indrora/veetee2350/docs/devlog/README.md

# VeeTee 2350 devlog

A running log of the build, one entry per micro-milestone, each with a
capture from the HDMI grabber (Genki ShadowCast 2) and notes on what
was learned.

1. [Choosing a parser: the libghostty-vt spike](001-choosing-a-parser.md)
2. [First light: DVI on GPIO 32–39](002-first-light.md)
3. [Fonts, and the case of the out-lined helper](003-fonts-and-text.md)
4. [It's a terminal](004-its-a-terminal.md)
5. [Two cores, one picture](005-two-cores.md)
6. [Switching fonts live](006-font-switching.md)
7. [A keyboard port, and making core 1 flash-free](007-keyboard-port.md)
8. [SET-UP](008-set-up.md)
9. [Six resolutions, two lurking bugs](009-resolutions.md)
10. [Knowing its own size](010-terminal-size.md)
11. [Emulation levels](011-emulation-level.md)
12. [Taking the tests](012-conformance.md)
13. [132 columns](013-132-columns.md)
14. [Sixel](014-sixel.md)
15. [Old-school fonts, and an SD card slot](015-oldschool-fonts.md)
16. [Fonts and colour schemes from the SD card](016-card-fonts-schemes.md)
17. [Screenshots, by the terminal itself](017-screenshots.md)
18. [Turning on the printer](018-printer.md)
19. [Fewer bytes, fewer bits, and Floyd–Steinberg](019-colour-depth.md)
20. [A night with esctest](020-conformance-night.md)
21. [A Tools menu, hotkeys, and a profiler bar](021-tools-menu.md)
22. [User lights and a status line that peeks](022-status-line.md)
23. [Capture and replay](023-capture-replay.md)
24. [A frame planner](024-frame-planner.md)
25. [ATI Small Wonder, a 72 Hz mode, and debug builds that show it](025-small-wonder.md)
26. [fastfetch](026-fastfetch.md)
27. [A USB keyboard on the board itself](027-usb-keyboard.md)
28. [A way out: BOOTSEL factory reset, the USB keyboard in every mode, a SET-UP that asks](028-a-way-out.md)
29. [Hands for the robot: an automation HID for debug builds](029-automation-hid.md)
30. [A real serial line: the header's UART, SET-UP split into pages, a poor man's getty](030-serial-line.md)
31. [Writing only in the blanking gap: no more torn frames under a flood](031-blanking-gap.md)
32. [A boot splash for the capture card](032-boot-splash.md)

How entries are made: capture with
`ffmpeg -f avfoundation -framerate 30 -i "ShadowCast 2" -frames:v 1 x.jpg`
from a terminal that has camera permission, then downscale into `img/`
with `sips -s format jpeg -s formatOptions 50 --resampleWidth 1280`.
