indrora/veetee2350/fonts/arbata-compact/readme.txt

2500+ glyphs pixel game font!

------------------------------------

Arbata Compact

Пиксельный шрифт из 2500+ символов для игр и развлечений. Максимальная высота символа 12px, базовая высота 7px для заглавных букв и 5px для срочных. Средняя ширина 5px для заглавных букв и 4px для срочных. Шрифт выглядит чётко при 12pt в 96dpi.

Почему я нарисовала этот шрифт:
* Мне нужно было, чтобы английские и русские буквы были максимально похожи друг на друга прямо в одном шрифте.
* Я не умею тормозить, и раз уж нарисовала А, то нарисую также À,Á,Â,Ã,Ä и Å, а потом запланирую Ạ,Ả,Ấ,Ầ,Ằ,Ẳ,Ẵ и Ặ на следующий апдейт.
* Я люблю игры, поэтому в шрифте очевидно должна быть полная колода карт и кнопочки геймпада.

Зачем вам нужен этот шрифт:
* В вашей жизни не хватало нового пиксельного шрифта с кириллицей.
* Вы хотите играть в карты и домино в текстовом редакторе.
* Вы нашли применение пиксельному шрифту Брайля.

Что есть в этом шрифте:
+ Латиница и ещё латиница с чёрточками и кружочками.
+ Кириллица и ещё кириллица с полочками и закорючками.
+ Много греческого тоже с закорючками.
+ Числа обычные, надстрочные, подстрочные, дроби.
+ Математические операторы, стрелки, фигуры.
+ Набор линий и блоков для рисования таблиц.
+ Колода карт, коробка домино, шахматы.
+ Ноты, цветочки, флажки и фазы луны.
+ Шрифт Брайля. Затем.

Чего (пока) нет в этом шрифте из важного:
- Никаких азиатских языков.
- Никаких африканских языков.
- Большинства эмодзи.
- Вообще много чего не влезло в 2500 символов, если честно.

Что будет в ближайшем обновлении:
* Больше иконок, которые можно использовать в играх и программах.
* Какая-нибудь дичь, которая мне больше всего понравится при случайном поиске по таблицам юникода. Я уже нашла древне-пермское письмо и приглядываюсь к нему, вместо того чтобы рисовать иероглифы.
* Ещё один шрифт на базе этого. В нём латиница и кириллица будут чуть пошире, а остальные символы такие же.

Что будет в более поздних обновлениях:
* Надеюсь, какие-нибудь иероглифы.
* Вся расширенная латиница и кириллица.
* Что-нибудь по заявкам пользователей.

Чего бы мне хотелось от вас:
* Комментариев, лайков, подписок. Я хочу общаться.
* Чтобы вы использовали этот шрифт в играх и по возможности упоминали меня в виде имени или ссылки сюда. Если упоминание по-русски, то я Ольга Яковлева.
* Чтобы вы задумались о донате мне, если вам шрифт понравился или вы его где-то использовали.
* Чтобы вы не использовали ничего из моих ассетов ни в чём, что связано с NFT.
------------------------------------

Arbata Compact

A pixel font with 2500+ glyphs for games and entertainment.  Max height is 12px, base height is 7px for capital letters and 5px for small letters. Average width is 5px for capital letters and 4px for small letters. The font looks sharp at 12pt in 96dpi.

Reasons for this font's existence:
* I wanted to have a font with very similar looking Latin and Cyrillic.
* I can't stop doing what I'm doing, so as I've finished A, I'm already drawing À,Á,Â,Ã,Ä, and Å, while planning to draw Ả,Ấ,Ầ,Ằ,Ẳ,Ẵ, and Ặ as soon as possible.
* I love games so there has to be a full deck of cards in my font, obviously.

You need this font because:
* Your life felt meaningless without a new pixel font with enough Cyrillic in it.
* You want to play cards and dominoes in your text editor.
* You've found a use for pixel Braille patterns.

What's there in this font:
+ Latin and more Latin with dashes and circles.
+ Cyrillic and more Cyrillic with sticks and hooks.
+ Greek also with sticks.
+ Numbers: regular, subscript, superscript, fractions.
+ Math, arrows, and stuff.
+ A set of lines and blocks to draw a table.
+ A deck of cards, a box of domino, and chess.
+ Notes, flowers, flags and moon phases.
+ Braille patterns. Just because.

What's missing:
- Asian languages.
- African languages.
- Most emojis.
- Frankly speaking, there's a lot that didn't fit into 2500 glyphs.

Plans for the next update:
* More pictograms for games and software.
* Something completely unnecessary but pretty like old permic instead of much needed hanzi and kana.
* Another font based on this one. It will feature more rounded Latin and Cyrillic.

Plans for later updates:
* Hopefully, some Asian languages.
* Full extended Latin and Cyrillic.
* Something from user suggestions.

What can you do for me:
* Comment-like-share-and-subscribe. I want to communicate.
* Use this font in games and credit me by linking here or mentioning my name if possible. If you use Latin-based languages, I'm Olga Yakovleva.
* Consider donating, if you use my font and if you like it.
* Don't use my assets anywhere related to NFTs.

------------------------------------
