indrora/veetee2350/capture.jpg

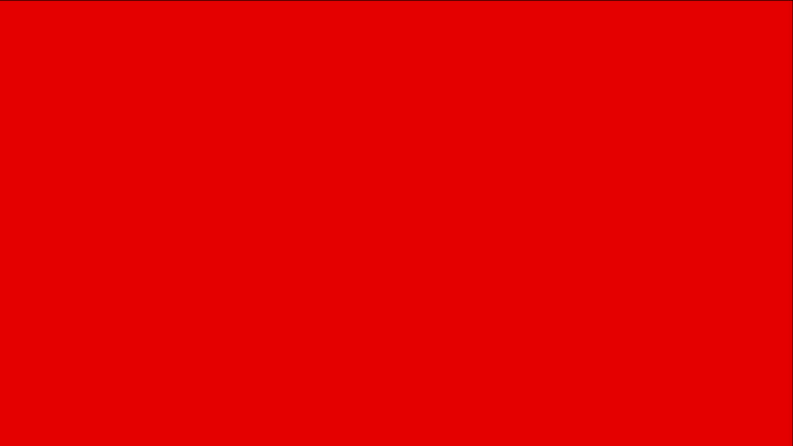
capture.jpg
