indrora/veetee2350/hardware/jlcpcb/production_files/BOM-hardware.csv

Comment | Designator | Footprint | LCSC | Quantity
100nF | C1,C2,C3,C4,C5,C6,C8 | C_0603_1608Metric | C14663 | 7
10k | R1,R2,R4,R5 | R_0603_1608Metric | C25804 | 4
10uF | C7 | C_0603_1608Metric | C19702 | 1
250mA hold | F1 | Fuse_1206_3216Metric | C70069 | 1
2N7002W | Q1,Q2 | SOT-323-3_L2.0-W1.3-P1.30-LS2.1-BR | C7420322 | 2
4.7k | R6,R7 | R_0603_1608Metric | C23162 | 2
DB9 male (DTE) | J2 | DSUB-TH_DMR-9P | C141880 | 1
PS/2 mini-DIN-6 | J3 | CONN-TH_DS1093-01-PN60 | C77848 | 1
TPT3122EH-QF8R | U1 | QFN-24_L4.0-W4.0-P0.50-TL-EP2.7 | C19188736 | 1
