indrora/veetee2350/docs/devlog/img/mode-640x480.jpg

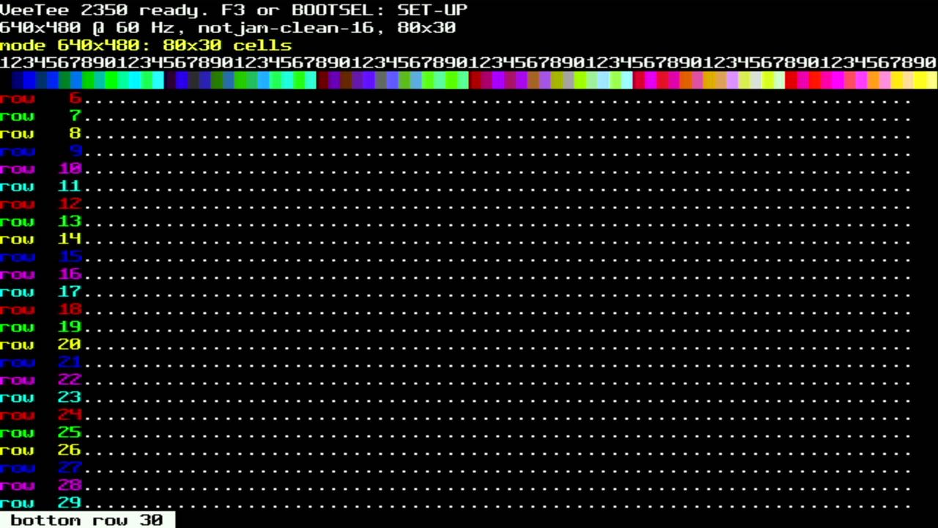
docs/devlog/img/mode-640x480.jpg
