indrora/veetee2350/hardware/hardware.kicad_pcb

## KiCad design hardware/hardware.kicad_pcb (2026-11-04)

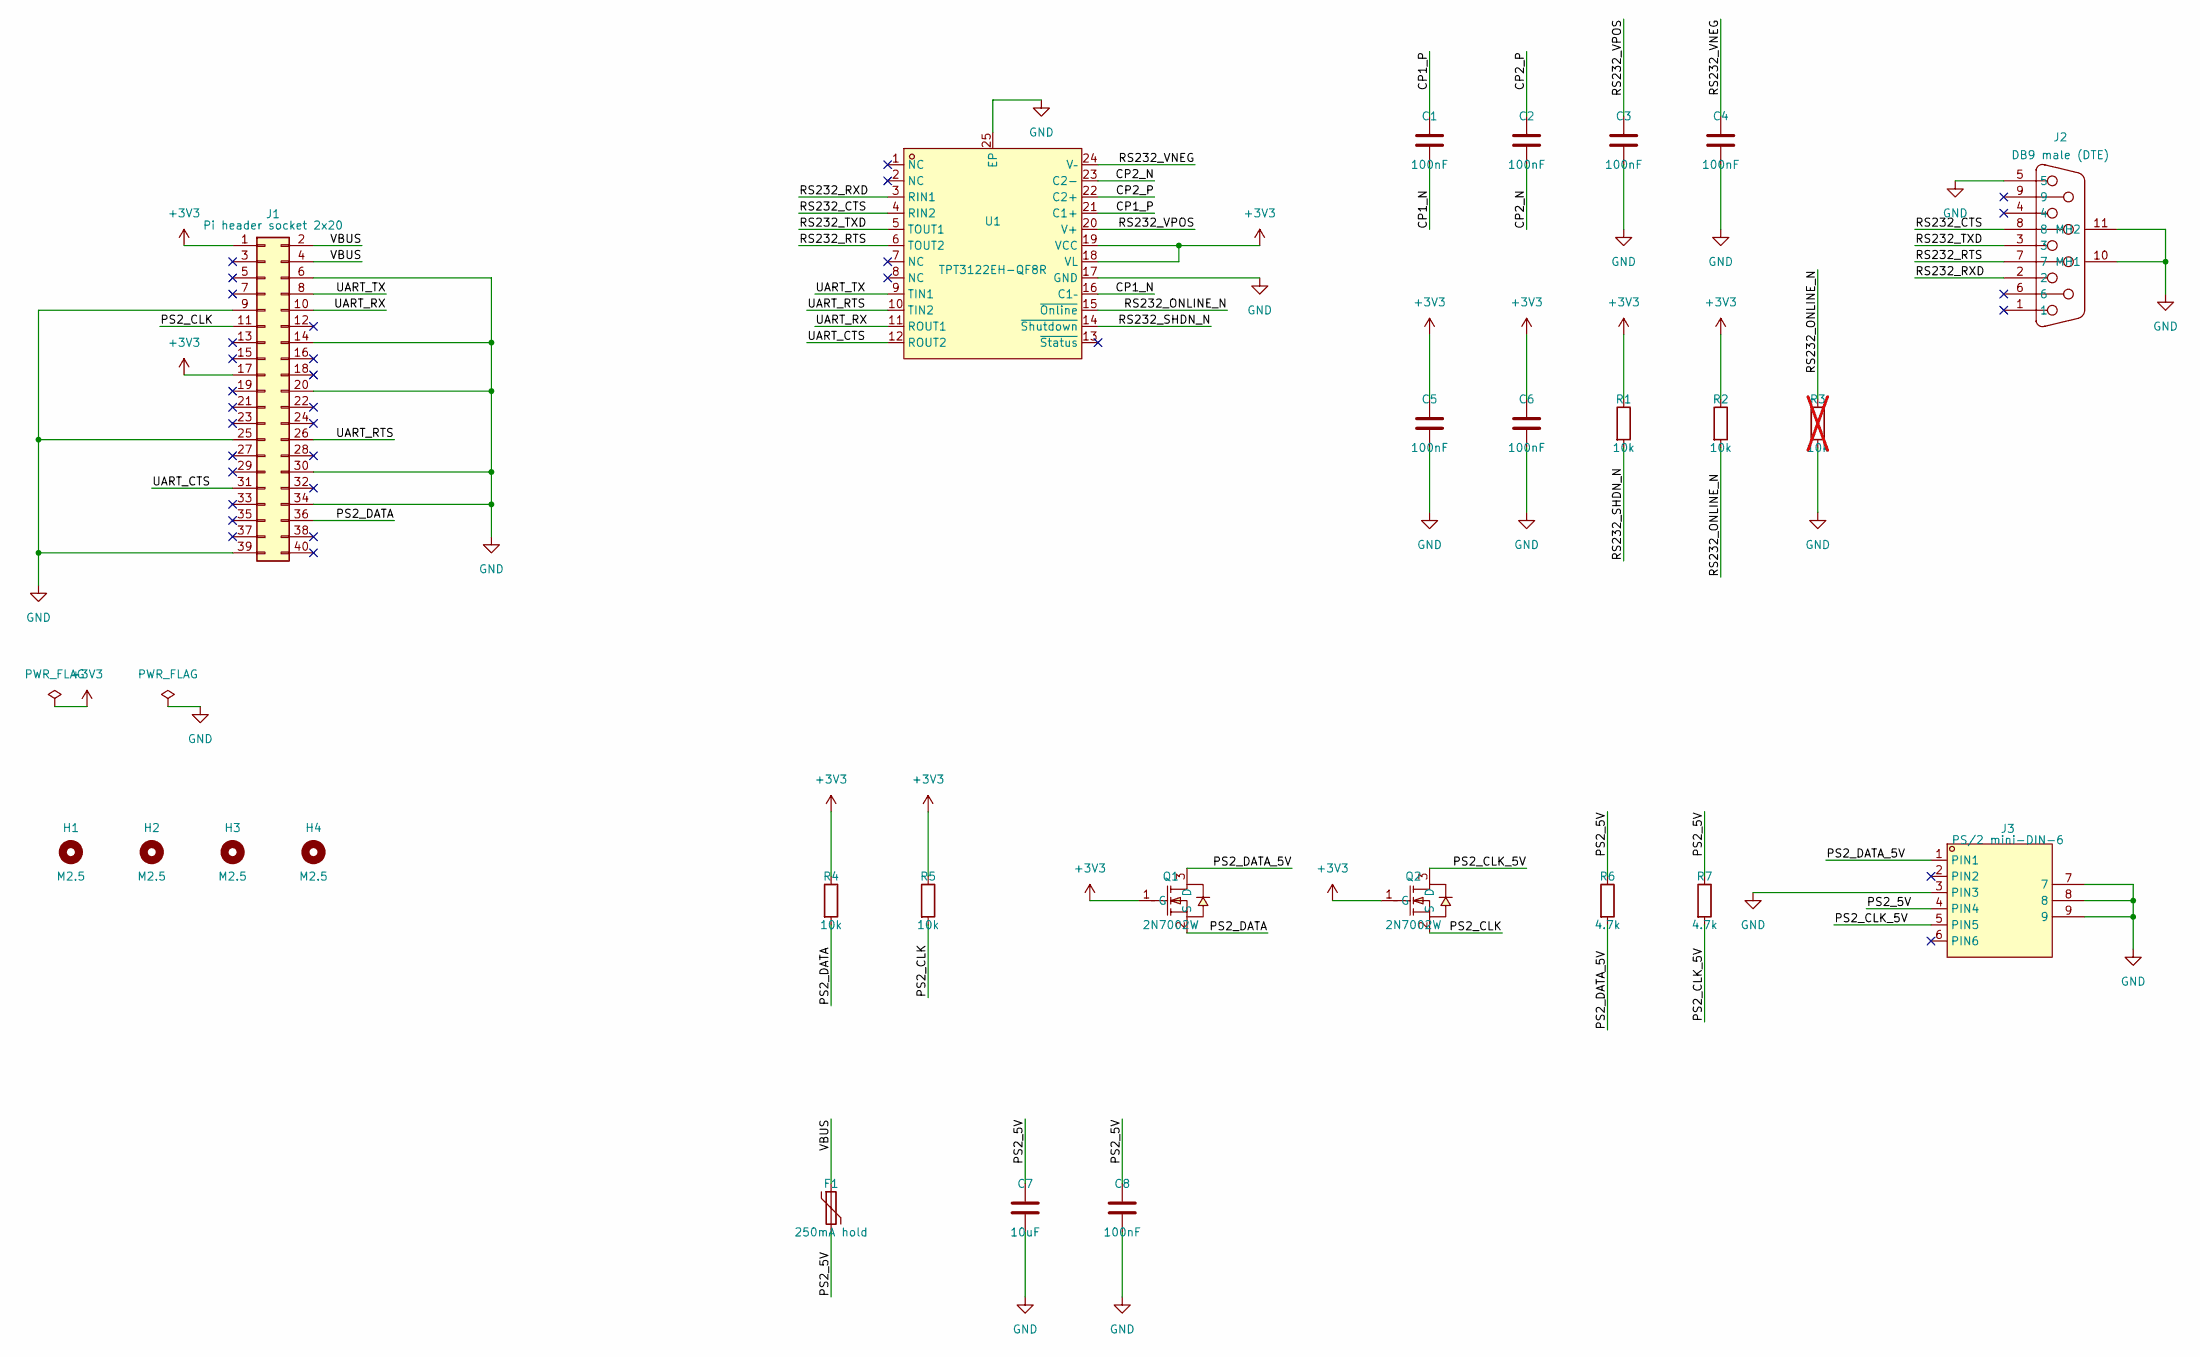
[picture p111: schematic hardware.kicad_sch, VeeTee 2350 HAT: RS-232 + PS/2]

Parts:
C1, C2, C3, C4, C5, C6, C8: 100nF; C_0603_1608Metric; LCSC C14663
C7: 10uF; C_0603_1608Metric; LCSC C19702
F1: 250mA hold; Fuse_1206_3216Metric; LCSC C70069
H1, H2, H3, H4: M2.5; MountingHole_2.7mm_M2.5
J1: Pi header socket 2x20; PinSocket_2x20_P2.54mm_Vertical; LCSC TBD
J2: DB9 male (DTE); DSUB-TH_DMR-9P; LCSC C141880
J3: PS/2 mini-DIN-6; CONN-TH_DS1093-01-PN60; LCSC C77848
Q1, Q2: 2N7002W; SOT-323-3_L2.0-W1.3-P1.30-LS2.1-BR; LCSC C7420322
R1, R2, R4, R5: 10k; R_0603_1608Metric; LCSC C25804
R3: 10k; R_0603_1608Metric; LCSC C25804; not fitted
R6, R7: 4.7k; R_0603_1608Metric; LCSC C23162
U1: TPT3122EH-QF8R; QFN-24_L4.0-W4.0-P0.50-TL-EP2.7; LCSC C19188736

Connections:
+3V3: C5.1, C6.1, J1.1, J1.17, Q1.1 (G), Q2.1 (G), R1.1, R2.1, R4.1, R5.1, U1.18 (VL), U1.19 (VCC)
/CP1_N: C1.2, U1.16 (C1–)
/CP1_P: C1.1, U1.21 (C1+)
/CP2_N: C2.2, U1.23 (C2-)
/CP2_P: C2.1, U1.22 (C2+)
/PS2_5V: C7.1, C8.1, F1.2, J3.4 (PIN4), R6.1, R7.1
/PS2_CLK: J1.11, Q2.2 (S), R5.2
/PS2_CLK_5V: J3.5 (PIN5), Q2.3 (D), R7.2
/PS2_DATA: J1.36, Q1.2 (S), R4.2
/PS2_DATA_5V: J3.1 (PIN1), Q1.3 (D), R6.2
/RS232_CTS: J2.8, U1.4 (RIN2)
/RS232_ONLINE_N: R2.2, R3.1, U1.15 (~Online)
/RS232_RTS: J2.7, U1.6 (TOUT2)
/RS232_RXD: J2.2, U1.3 (RIN1)
/RS232_SHDN_N: R1.2, U1.14 (~Shutdown)
/RS232_TXD: J2.3, U1.5 (TOUT1)
/RS232_VNEG: C4.1, U1.24 (V–)
/RS232_VPOS: C3.1, U1.20 (V+)
/UART_CTS: J1.31, U1.12 (ROUT2)
/UART_RTS: J1.26, U1.10 (TIN2)
/UART_RX: J1.10, U1.11 (ROUT1)
/UART_TX: J1.8, U1.9 (TIN1)
/VBUS: F1.1, J1.2, J1.4
GND: C3.2, C4.2, C5.2, C6.2, C7.2, C8.2, J1.6, J1.9, J1.14, J1.20, J1.25, J1.30, J1.34, J1.39, J2.5, J2.10 (MH1), J2.11 (MH2), J3.3 (PIN3), J3.7, J3.8, J3.9, R3.2, U1.17 (GND), U1.25 (EP)

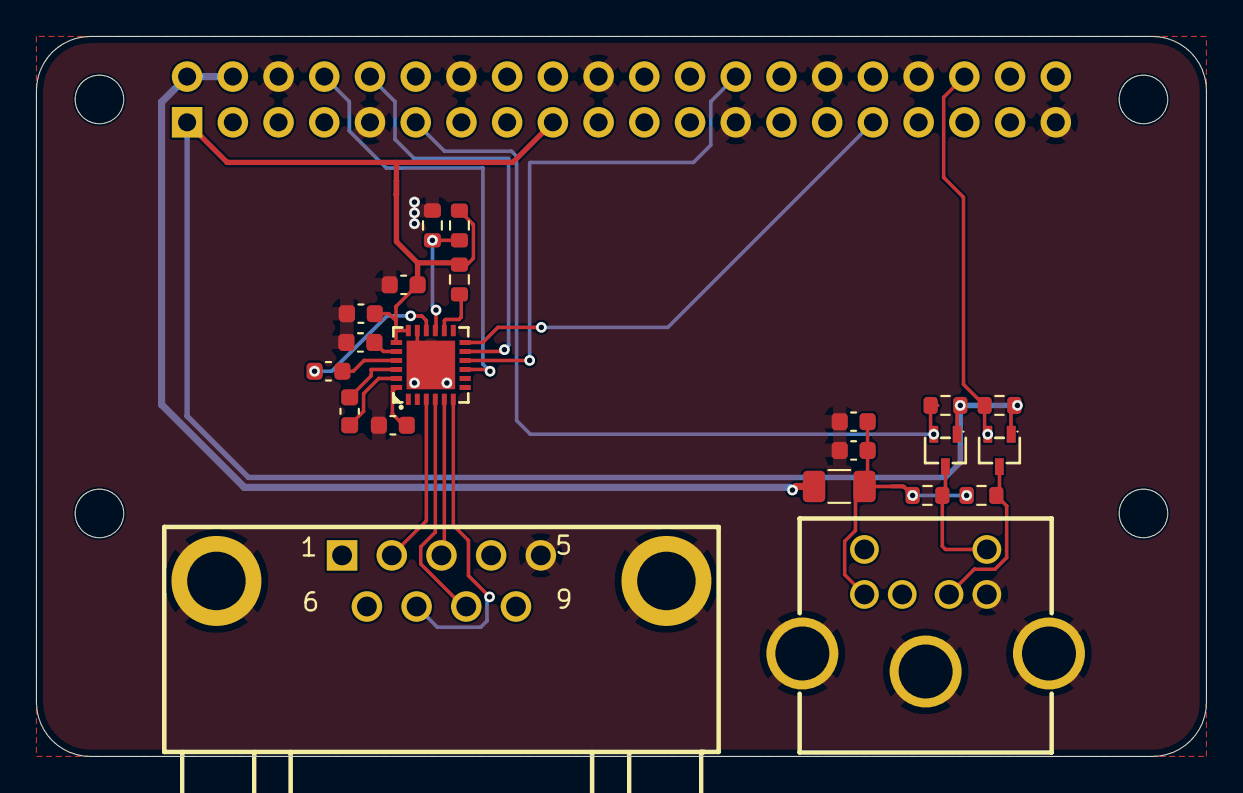
[picture p112: board hardware.kicad_pcb from above]

Board: 2 copper layers, 65.0 x 40.0 mm, 26 parts (1 on the bottom side), 24 nets.
