indrora/veetee2350/(commit log)

2026-11-02 build: scaffold PlatformIO project with DVI test pattern
    Adds STYLE.md and CLAUDE.md, a PlatformIO env for the Waveshare
    RP2350-PiZero (arduino-pico, C23), vendored libdvi patched for TMDS
    pins on GPIO 32-39, a video HAL that renders RGB565 scanlines on core 1
    through the SIO TMDS encoder, and a test pattern that reports per-line
    cycle usage over USB serial.
2026-11-02 hal: fit DVI scanout in the line budget, document hardware
    Two TMDS symbols per FIFO word lets the SIO encoder pop a pixel pair per
    read; with a 4x unrolled loop and core 1 bus priority, encode drops from
    9.2k to 4.4k cycles per line (budget 8k), giving a stable 60 fps. The
    test pattern now copies precomputed rows. Verified on hardware via the
    Genki capture: bar order, ramps and pixel checkerboard are correct.
2026-11-02 render: text demo on hardware, fit the renderer near the line budget
    Demo screen cycles through all built-in fonts (verified by capture:
    colours, truecolor sweep, attributes, box/DEC glyphs, cursor). Render cost
    cut from ~6300 to ~3000 cycles/line: force-inline hot helpers (-Os had
    out-lined one into flash), build lib/render at -O2, index a 256-entry
    mask table by the whole glyph byte, and apply attributes through a
    precomputed per-row (and, or) table instead of a call. Measurements and
    the capture-by-name command are in docs/hardware.md.
2026-11-02 term: libvterm-driven terminal on the DVI screen
    Vendors libvterm 0.3.3 (MIT, unmodified) and adds lib/term, which turns
    its state-layer callbacks into grid writes: glyphs with resolved SGR
    colours/attributes, row-map fast scrolling with moverect/erase fallback,
    BCE erase, alternate screen as a second grid, cursor/DECSCNM/DECSCUSR
    modes, and device replies back to the host. USB CDC bytes now feed the
    terminal. tools/hostshell.py runs a Mac shell in an 80x30 pty bridged to
    the board; verified on hardware with a colour/DEC graphics demo and less
    (captures/g1-*.jpg). 23 host tests pass. Notes in docs/terminal.md.
2026-11-02 hal: render on core 0 from a doorbell IRQ, encode-only core 1
    The scanline callback now runs on core 0 in a top-priority SIO doorbell
    IRQ, filling an 8-line ring that core 1 drains for TMDS encoding. On the
    worst-case screen core 1 is a steady 4348/8000 cycles and core 0 renders
    in ~3660, with no starved lines (it used to be ~8074/8000 with both on
    core 1). Doorbell 7, not 0: arduino-pico's shared bell handler idles the
    core forever on doorbell 0 even in single-core mode.
    Adds a pizero-stats env for measuring, and tools/refscreen.py (pyte) as
    an independent reference screen. fastfetch verified on hardware
    (captures/g1-fastfetch.jpg) and matches pyte row for row.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
2026-11-02 term: runtime font switching via OSC 50
    The terminal now owns its font. xterm's OSC 50 selects a built-in font by
    name (or #+/#- to cycle, ? to query); a switch rebuilds both screens at
    the new grid size, resizes libvterm and hard-resets it. libvterm rects
    are clamped to the grid for the resize window, and render_pause only
    waits when scanout is live. tools/setfont switches and re-reads the size
    resize(1)-style so the pty gets SIGWINCH; tools/fontshow.sh cycles fonts.
    Verified on hardware in five fonts (captures/font-*.jpg). 25 host tests.
2026-11-02 hal: second USB CDC as the keyboard port; core 1 made flash-free
    Switches to Adafruit TinyUSB (the native stack has one CDC) and adds a
    "VeeTee keyboard" CDC next to the "VeeTee line": keys written to it are
    forwarded to the host over the line, completing Goal 1's loopback
    keyboard. hal/usbio.h replaces console.h; hostshell.py --keyboard routes
    the Mac's keys through the device.
    Core 1 was executing flash after all: -Os out-lined libdvi's queue
    helpers, the SDK queue level helper and dma_channel_get_default_config
    (called per scanline in the DMA IRQ). They're now force-inlined or
    precomputed (PicoDVI PATCHES.md 3-4), PicoDVI and hal build at -O2, and
    tools/core1_audit.py walks core 1's call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
2026-11-02 docs: start the devlog with entries 001-007
    Backfills blog-style entries with downscaled captures for each milestone
    so far (spike, first light, fonts, terminal, two cores, font switching,
    keyboard port) and notes the practice in CLAUDE.md.
2026-11-02 feature: VT-style SET-UP screen with settings saved to flash
    F3 on the keyboard port (or the BOOTSEL button) opens SET-UP: font
    (terminal size), rows (auto/24/25), colour scheme (xterm grey, green/
    amber/white phosphor, paper), cursor shape/blink, auto-wrap, new-line
    mode, local echo, visual bell and answerback, plus save/recall/defaults/
    reset. It draws into its own grid so the session underneath is left
    alone. Settings are a CRC-sealed record in the last flash sector, applied
    at boot and on exit; modes are applied by feeding libvterm the escape
    sequences a host would send; ENQ answers with the answerback.
    New pure modules lib/input (key decoder) and lib/setup (settings, menu)
    with host te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
2026-11-02 feature: six output resolutions up to 1280x720, crash recovery
    SET-UP gains Resolution: 640x480, 720x480, 800x480, 960x540 @60,
    1280x720 @30 and a 1280x720 @24 "low clock" mode (297 MHz). Each mode
    sets VREG, flash timing and sysclk = TMDS bit clock at boot; video and
    render now use runtime sizes; changing mode saves and reboots. All six
    verified on the Genki.
    Fixes found on the way:
    - libdvi TMDS buffers overran by up to 15 words when a lane isn't a
    multiple of the unrolled encode block (720 px), corrupting the next
    heap block (PicoDVI PATCHES.md 5).
    - Flash QMI timing: computed per clock (probed with the new
    pizero-flashprobe env), a transition timing while set_sys_clock_khz
    runs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
2026-11-02 feature: terminal size setting and host size sync (DECSET 2048)
    Full-screen apps used only part of the screen because the host never
    learned the grid size. The terminal now answers xterm window-op size
    queries (CSI 14/16/18/19 t) and implements in-band resize reports
    (DECSET 2048: CSI 48;rows;cols;h;w t on enable and after every font/
    size/resolution change, plus DECRQM). libvterm patch: unknown DEC modes
    and their DECRQM go to the CSI fallback. hostshell.py enables 2048,
    starts the shell at the reported size and applies later reports with
    TIOCSWINSZ (SIGWINCH).
    SET-UP "Rows" becomes "Terminal size": full or fixed 80x24/25/43/50 and
    132x24/43, letterboxed and clamped to what fits (settings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
2026-11-02 feature: emulation level (VT100/VT220/VT340/xterm) with feature toggles
    SET-UP gains Emulation, Colour depth, UTF-8 and Alternate screen. A level
    sets the DA1/DA2 replies (libvterm patch 2 lets the embedder answer DA)
    and loads feature defaults that can then be overridden:
    - colour depth: mono ignores SGR colours, 16/256 map to the nearest
    ANSI / xterm-256 colour (new lib/term/colour), 24-bit passes through;
    - UTF-8 off: C1 bytes become 7-bit ESC forms and GR bytes Latin-1, done
    in front of libvterm (which only has 94-character sets);
    - alternate screen off: the settermprop callback vetoes the switch so
    libvterm doesn't erase the primary screen.
    Settings v4; SET-UP relaid out to fit 80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
2026-11-02 term: DECRQCRA readback, protected cells, double-width/height lines
    - DECRQCRA (CSI Pid;Pp;Pt;Pl;Pb;Pr * y -> DCS Pid !~ XXXX ST): codepoint
    sum over a rectangle, erased cells 0, via a glyph->codepoint table in
    the font and a CELL_ERASED marker (masked out by the renderer). This
    lets esctest2 read the screen back. libvterm patch 3: CSI with
    intermediates it doesn't parse reaches the fallback.
    - DECSCA protection: CELL_PROTECTED from libvterm's protected_cell;
    selective erase (DECSED/DECSEL) skips protected cells.
    - DECDWL/DECDHL: per-physical-row line size from setlineinfo (moves with
    scrolling, reset on new lines), rendered by a pixel-doubling slow path
    with double-height halv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
2026-11-02 term: conformance work driven by esctest2 (30% -> 68% so far)
    - DECRQCRA counts erased cells as spaces (xterm >= 334, as claimed).
    - OSC 4/5/104/105, OSC 10-19/110-119 colour set/query/reset (X11 rgb:,
    rgbi:, #hex specs), OSC 4 256+ special-colour aliases.
    - XTGETTCAP (Co/colors, TN/name, RGB).
    - DECRQM for ANSI and DEC modes: real IRM/LNM, permanently-reset ANSI
    modes, and a store for accepted-but-inert modes (DECARM, DECNKM, ...).
    - DECDSR printer/UDK/keyboard/locator/macro/checksum/integrity/session.
    - REP; DECFRA/DECERA/DECSERA/DECCRA rectangles; DECRQCRA in origin mode.
    - libvterm patches 4-7: unknown ANSI modes and DSR to the fallback,
    DECXCPR page, SCOSC/SCORC, reverse wraparoun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
2026-11-02 test: esctest2 at 72%, DECRQSS, vttest capture tour, devlog 012
    esctest2 now passes 408 of 567 (baseline 169). This round:
    - libvterm patch 8: DECRQSS SGR replies in xterm's replayable "0;..."
    form, and settings libvterm doesn't track go to the DCS fallback,
    where lib/term answers DECSCL, DECSLPP, DECSNLS, DECSACE, DECSASD
    and DECSSDT.
    - libvterm patch 7 extended: RIS/DECSTR clear reverse wrap and the
    DECSC save (position, DECOM, protection), and seed the saved pen
    with the default pen, so DECRC with nothing saved no longer restores
    black-on-black RGB.
    - tools/vttest_tour.sh drives vttest through the keyboard port and
    grabs a frame per screen; devlog 012 has the results, inclu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
2026-11-02 feature: DECCOLM 132-column mode where the screen fits; libvterm resize fix
    CSI ?3h switches to 132 columns when the resolution and font have room
    (the 720p modes, 1056 px at 8 px per column) and is ignored otherwise,
    like xterm with 80/132 switching disallowed. CSI ?3l returns to the
    width SET-UP configured, so `reset` can't shrink a full-width screen.
    A switch clears (unless DECNCSM), homes, resets margins and sends a
    DECSET 2048 size report. Mode 40 can disable it. It runs synchronously
    in libvterm's CSI dispatch so the rest of the chunk lands at the new
    width.
    libvterm patch 9: on_resize() never reallocated the per-row line info
    (it compared against state->rows after overwriting it, and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
2026-11-02 feature: Sixel graphics as graphic cells
    Images from "DCS P1;P2;P3 q ... ST" are drawn into CELL_GRAPHIC cells:
    the glyph index names a font-cell-sized 8-bit tile in a heap pool, and
    the renderer copies tile rows through a shared 256-entry RGB565 palette
    (255 = transparent). Scrolling, erase, DECCRA, the alternate screen and
    text overwrite all work through the existing grid. Unreferenced tiles
    are reclaimed by a mark-sweep over both screens.
    - lib/sixel: streaming decoder (raster attributes, RGB/HLS colour
    definitions, repeats, bands), no allocation.
    - lib/term/graphics.c: tile pool, palette slots shared by value, xterm
    placement and sixel scrolling, DECSDM (80), private registers
    (10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
2026-11-02 feature: TUOPFP built-in fonts; SD card storage layer
    Fonts from VileR's Ultimate Oldschool PC Font Pack (CC BY-SA 4.0),
    converted to PSF2: rainbow100-80 (the DEC Rainbow's 10x10 double-scan
    font, cropped to an 8x20 cell: 80x24 at 640x480), nix8810-m16,
    fmtowns-8x16 and fmtowns-8x8.
    lib/hal/storage.h: a C file API for the microSD slot, implemented in
    src/storage_sd.cpp on arduino-pico's SdFat over hardware SPI1 (GP30
    SCK, GP31 MOSI, GP40 MISO, GP43 CS; no PIO). SET-UP probes the card on
    entry and shows its size and type, or why it couldn't mount, in the
    title row. Verified on hardware with no card inserted.
    Devlog 015 with the fonts on screen. STYLE.md now names both C++
    shims in src/.
    Co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
2026-11-02 feature: fonts and base16 colour schemes from the SD card
    - src/card.c: /fonts/*.psf and /schemes/*.yaml listed for SET-UP (first
    64 of each, caveat emptor), loaded on apply. The listing is cached in
    /veetee/catalog.bin under an FNV-1a fingerprint of both folders;
    scanning feeds the watchdog and reports progress on SET-UP's message
    line.
    - src/storage_sd.cpp now uses SdFat directly: arduino-pico's SD
    wrapper re-opens each directory entry by path, making listings
    quadratic (a full TUOPFP card tripped the 8 s watchdog). storage_list
    can peek at each file's first bytes through the open entry.
    - lib/setup/base16.c: parser for both base16 file generations and
    base16-shell's termin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
2026-11-02 docs: Configuration Error capture with the card pulled; grabber caveat
    The missing-card case works: both card items listed with their reason,
    defaults used. The grabber wedges on such boots (board stats show
    clean video) until replugged; noted in docs/hardware.md.
2026-11-02 feature: F12 screenshots to the SD card, BMP or QOI
    F12 re-renders every scanline through the live renderer (there is no
    framebuffer) and streams it to /screens/NNNN.bmp (16-bit RGB565,
    top-down) or NNNN.qoi (24-bit, bit-replicated widening). SET-UP gets a
    "Screenshot (F12)" format item (settings v7). Success flashes the
    screen or, in SET-UP, names the file and time; failure says why.
    lib/qoi: a streaming QOI encoder from the spec (the reference encoder
    needs the whole image in RAM). Its colour cache tracks alpha: the
    decoder starts slots at (0,0,0,0), and treating an empty slot as
    opaque black desynchronised the decoder on the first device file.
    Unit tests pin the hand-worked bytes and tha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
2026-11-02 feature: printer port (Media Copy) to /print on the SD card
    SET-UP "Printer" (settings v8). With it on, MC prints to
    /print/NNNN.txt (a new file each time the printer is switched on):
    print screen (scrolling region, or all with DECPEX; DECPFF form feed),
    print cursor line, auto print (CSI ? 5/4 i), and printer controller
    mode (CSI 5 i ... 4 i, raw, not displayed). CSI ? 15 n reports ready /
    not ready / none. Text is UTF-8, trailing blanks dropped, CR LF.
    lib/term/printer.c recognises the controller-mode switches before
    libvterm (which would otherwise consume the rest of the buffer),
    across chunk boundaries, holding at most three bytes; it also splits
    at LF/VT/FF for auto print, flushing ear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
2026-11-02 term: esctest 407 -> 451 -- DECBI/DECFI, margins, window ops, DECID
    - libvterm patch 10: DECBI/DECFI (ESC 6 / ESC 9), scrolling the
    margins sideways at the left/right margin.
    - libvterm patch 11: CR/CNL/CPL go to the left margin; CUU/CUD/CUF/
    CUB/CNL/CPL stop at margins they start inside; CPR/DECXCPR are
    origin-relative.
    - libvterm patch 12: DECALN resets the margins and homes the cursor.
    - Window ops: titles and icon labels from OSC 0/1/2 with reports (20t,
    21t) and xterm's title stack (22t/23t: one stack, every push saves
    both, a pop consumes the entry); iconify/move remembered for 11t/13t;
    15t; resize requests accepted and ignored.
    - DECID (ESC Z, arrives as C1 SCI) answered a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
2026-11-02 term: esctest 451 -> 474 -- per-screen saves, margins for text and index, xterm 383+ reverse wrap, DECSCL levels
    - libvterm patch 13: a DECSC save per screen (main / alternate), as
    xterm; 1049 saves on main before switching.
    - patch 14: LF/IND/NEL/VT/FF/RI outside the left/right margins neither
    scroll nor move past the margin.
    - patch 15: text between DECSLRM margins wraps at the right margin to
    the next line's left margin; no-autowrap sticks there; IRM truncates
    there.
    - patch 16: reverse wraparound as xterm 383+: mode 45 only onto lines
    that wrapped, new mode 1045 always (top margin -> bottom); stops at
    and lands on margins; BS in the pending-wrap position cancels it.
    - patch 1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
2026-11-02 term: esctest 474 -> 489 -- REP, NEL/DCH, CUB reverse wrap, XTSAVE, margin tabs, alt-screen clearing
    libvterm patches 19-26 (see lib/libvterm/PATCHES.md):
    19 REP prints like text (wraps at the right margin), replacing term.c's
    REP fallback.
    20 NEL obeys the CR margin rule; DCH only needs the L/R margins;
    DECSTBM needs at least two lines.
    21 CUB with reverse wraparound is repeated BS (back_space()).
    22 XTSAVE / XTRESTORE (CSI ? Pm s / r), libvterm's own modes in the
    state and term.c's stored modes through the CSI fallback.
    23 HT/CHT stop at the right margin when inside the margins; CBT still
    runs to column 1.
    24 DECSET 41, xterm's more(1) fix.
    25 Alternate-screen clearing per mod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
2026-11-02 term: DECNCSM only at conformance level 5, as xterm
    DECNCSM (mode 95, keep the screen across a DECCOLM switch) is a VT510
    feature. xterm honours it only at level 5; below that the switch clears
    regardless. VeeTee's emulations top out at level 4 (VT420), so the mode
    is now stored and reported but has no effect. Fixes esctest's
    DECSCL_Level4_SupportsDECSLRMDoesntSupportDECNCSM (490 / 567 expected
    on a full run; checked with a DECSCL/DECCOLM/RIS subset).
2026-11-02 term: ISO protected areas (SPA/EPA), libvterm patch 27
    SPA (ESC V) and EPA (ESC W) set and clear the protected bit DECSCA
    already uses, and the state remembers which of the two set it last
    (protect_iso). After SPA, plain ED, EL and ECH spare protected cells
    as xterm does; after DECSCA only DECSED/DECSEL do. DECSERA in term.c
    honours DEC protection only. Soft and hard reset go back to DEC rules,
    so RIS still erases everything (the reason this was left alone before).
    esctest2 run25: ECH/ED/EL_respectsISOProtection pass; DECSED/DECSEL
    _doesNotRespectISOProtect become expected failures (xterm's known bug,
    which we now share); DECSERA_doesNotRespectISOProtect regressed in
    run25 and is fixed here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
2026-11-02 feature: Tools menu on Ctrl+F3, renderer overlays, key modifiers
    - keys.c decodes xterm's modifier parameter (CSI 1;m X, CSI n;m ~,
    SS3 m X) into key_event.mods, and ESC + printable as Alt+key;
    keys_name() formats "Ctrl+F3" for menus.
    - Settings v10: hotkeys per tool (Tools menu Ctrl+F3, Screenshot F12,
    the rest unbound), plus status line, peek time and capture fields for
    the rest of phase H, so the record only changes once.
    - lib/setup/menu.c: the Tools menu (Set-Up, Screenshot, Print screen,
    Printer, Clear screen, Soft reset, Hard reset), drawn into its own
    cells in the theme's colours swapped.
    - render.c: overlays (menu, user lights) composed over a copy of the
    covered rows,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
2026-11-02 feature: SET-UP Hotkeys page, scrolling item list
    SET-UP's new "Hotkeys..." item opens a page listing the tools: Enter,
    then the key to bind (with modifiers; Esc cancels), Delete to unbind.
    A key runs one tool: binding it elsewhere takes it from its old tool,
    and the message line says so. Tools not built yet aren't listed
    (tool_ready() in menu.c).
    The item list now scrolls, with '^'/'v' marks, and the help and message
    lines always sit at the bottom. The old layout put every item on screen
    at once and assumed 24 rows: at 23 items the help line had already
    fallen off an 80x24 screen, and phase H adds more items.
2026-11-02 feature: profiler bar, settings upgrade from older versions
    - SET-UP "Profiler bar": the top 8 scanlines show last frame's cycles
    a line against the budget -- core 0 render (overlay composing in
    yellow, the rest green) and core 1 TMDS encode (blue), red ticks at
    the worst line, white at the budget (80% of the width). Filled once
    a frame by the main loop from hal/video's stats; the compose share
    needs a VEETEE_RENDER_PROFILE build. The profile counters are now
    running totals that readers difference.
    - Settings v11 (profiler_bar). settings_upgrade() reads records from
    version 9 on, whose layouts are prefixes of today's: old fields kept
    (up to where each version's fields ended,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
2026-11-02 feature: VT100 user lights and a status line (bottom, top, peek)
    DECLL (CSI Ps q) sets the four user lights; RIS puts them out (libvterm
    patch 28: a reset notification). lib/term/status.c draws an indicator
    status line -- lights, the printer, Insert, messages, the cursor -- in
    the theme's colours swapped, into a row of cells the renderer draws
    outside the grid (render->status_cells, RENDER_LINE_STATUS lines).
    SET-UP: Status line (hidden / bottom / top / peek bottom / peek top)
    and Peek time (3/5/7/10 s). Bottom and Top reserve a row; the Peek
    modes slide the row in over the edge row on news and away again by
    rewriting that row's line tables (render_status_peek). With no
    indicator on screen,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
2026-11-02 docs: devlog 022, user lights and the peeking status line
    Captures of every mode on the board, two frames caught mid-slide, the
    231-cycle regression and how it went, and the plan's Hidden rule
    revised (a host request no longer resizes the terminal).
2026-11-02 feature: capture to SD as ttyrec, replay with a file picker
    Capture (Tools menu, hotkey, SET-UP) writes host output and local echo
    to /capture/NNNN.rec as ttyrec records, buffered 4 KB, flushed when
    quiet, closed after an idle second. Replay file... opens a picker over
    the screen (lib/setup/picker.c; box drawing shared with the Tools menu
    in box.c) and plays ttyrec with its timing (gaps cut to 2 s) or any
    other file raw at 9600 baud; Space pauses, Up/Down speed (1/4x..max),
    n toggles LF -> CR LF, Esc stops. Host input waits, the terminal's
    replies to replayed queries are dropped. The pacing is pure and
    host-tested (lib/ttyrec).
    SET-UP: Capture, and Replay newlines (as in the file / raw file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
2026-11-02 feature: frame planner -- spans, row kinds, a preloaded colour-pair table
    Once a frame the main loop plans the next (render_plan): each text row
    becomes spans of grid or overlay cells, each PAIR (plain text in the
    frame's commonest fg/bg), PLAIN or MIXED, and the scanline runs a loop
    made for each. Overlays are spans, so nothing is composed in the IRQ.
    PAIR spans draw from a 4 KB table of each glyph byte's pixels already
    in that pair, and their rows are preloaded into SCRATCH_X. A stale plan
    (it may be a frame old) costs speed, never pixels: the lean loops hand
    cells they can't draw to the full loop.
    Measured (profile build, 640x480 80x30): plain text 4201 -> 2601
    cycles a line, Tools menu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
2026-11-02 docs: devlog 024, the frame planner; hot-path rules in STYLE.md
    Where the cycles went (experiments table), the plan, what it bought
    (chart and table), and what broke: the lean loop's literal reloads,
    core 1 starving while Sixel pictures arrived, preload slowing PLAIN
    rows, the memset in the render IRQ. No board pictures: the capture
    card lost its signal and these numbers came over USB.
2026-11-02 docs: devlog 024 on screen -- the planner checked on the board
    After the capture card was replugged: plain, menu, colours, attributes,
    Sixel, menu over double-width lines, reverse video, picker and corner
    lights all draw right. Two older warts noted (Sixel pool stops at 2048
    cells; a menu over double-width rows is doubled and clipped), the v9
    settings upgrade seen on hardware, and the DVI_USE_SIO_TMDS_ENCODER
    line that rode along in b5ad840.
2026-11-02 feature: 640x480 @ 72 Hz (VESA, 315 MHz), listed after 60 Hz
    The heatsink makes 315 MHz at 1.25 V comfortable: 24% more text
    throughput (174 vs 140 KB/s scrolling), the same per-line budget.
    Appended to the mode enum (settings store the index); SET-UP lists
    modes in video_mode_order instead. Not the default: the ShadowCast
    capture card won't lock to this VESA-only timing.
2026-11-02 docs: devlog 025, ATI Small Wonder, 72 Hz, debug builds
    Measurements for the 6-px paths and the 72 Hz mode, why 72 Hz isn't
    the default (the capture card), the profiler-bar leak, and loop
    alignment.
2026-11-02 feature: USB keyboard support, waiting on Pico-PIO-USB to switch it on
    lib/input/hidkbd.c (pure, host-tested): boot-protocol reports to the
    same key events the keyboard CDC port makes, so hotkeys, the Tools
    menu, SET-UP and replay take either. US layout, Caps/Num/Scroll Lock
    with LEDs, auto-repeat (500 ms, 30/s), keys only on changes between
    reports (this board's PIO-USB repeats the last one after an unplug).
    New key codes appended: the keypad, Print Screen, Pause.
    term_key_bytes(): the bytes a key sends, from libvterm's keyboard
    encoder, so DECCKM, DECKPAM and LNM decide them as on a real terminal.
    lib/hal/usbhost.c: TinyUSB host on the PIO-USB port (GPIO 28/29, PIO
    1, a free DMA channel,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
2026-11-02 feature: USB host on the board's PIO-USB port, keyboard enumerates
    lib/pico_pio_usb: Pico-PIO-USB 0.5.2 (MIT), vendored from Waveshare's
    RP2350-PiZero demo (PROVENANCE.md), with pioasm-generated headers and
    three patches (PATCHES.md): the host calls TinyUSB 3.7.7 needs, bus
    counters for debug builds, and any PIO block -- transmit and receive
    can't share one, both programs use PIO IRQ flag 1, which failed every
    SETUP until receive moved to PIO 2.
    usbhost.c: TX on PIO 1, RX on PIO 2, GPIO 28/29. Debug builds print a
    [usb] line with the port state and bus counters. On the board: the
    keyboard (36b0:30e7) mounts, DVI keeps 60 frames with nothing starved.
    Typing on it is the next check.
    Co-Autho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
2026-11-02 feature: boot banner says why the chip last reset; keyboards get Num Lock
    board_reset_reason() reads the RP2350's latched POWMAN CHIP_RESET
    flags: power-on, brown-out, RUN pin, watchdog, debugger, glitch,
    software. A brown-out gets a hint, since plugging a keyboard into the
    board's USB host port (5 V straight off the supply, no switch) browns
    the chip out. Each keyboard gets the decoder's LEDs as it attaches, so
    Num Lock lights: a visible sign it mounted.
2026-11-02 fix: one F12 press took two screenshots; debug key and HID tracing
    The screenshot ran inside the keyboard report's handler, and TinyUSB
    only asked for the next report afterwards, so the key-up couldn't
    arrive during the second of SD writes, and auto-repeat fired a second
    F12 on return. Now the next report is requested before a report is
    handled (copied first: the transfer reuses its buffer), and a poll gap
    over 100 ms restarts the repeat delay instead of firing. Host-tested.
    Debug builds print each HID report from every interface ([hid]) and
    where each key went ([key] ... -> host/menu/hotkey/set-up). Normal
    builds' banner says "on, no keyboard yet" instead of bus counters.
    Docs: the USB key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
2026-11-02 docs: devlog 027, a USB keyboard on the board itself
    Typing on the board's own USB port, with fastfetch to prove it; the
    port's constraints (timing, 12 MHz clocks, unswitched 5 V); the three
    patches to Waveshare's Pico-PIO-USB 0.5.2, PIO flag 1 above all; the
    plug-in brown-out and the banner's reset reason; one F12, two
    screenshots; and the grabber going dark again. The picture shows the
    Mac's username and specs, as in devlog 026.
2026-11-02 docs: devlog 027, the USB keyboard on tape
    The user's recording shows Ctrl+F3 opening the Tools menu from the USB
    keyboard, the arrows walking it to Replay file, and the captured session
    replaying cleanly off the SD card. Every key this keyboard has worked;
    the old text wrongly said it had no arrows. Caps Lock, keypad and lock
    LEDs stay host-tested only. Two stills from the video added.
2026-11-03 feature: BOOTSEL factory reset, USB keyboard in every mode, SET-UP asks
    A way out of settings you can't undo without a keyboard (the user got
    stuck at 720p24 with the keyboard port off).
    - Holding BOOTSEL 5 s saves factory defaults and restarts, after a
    countdown in SET-UP; letting go cancels, and the restart waits for
    the button to be released (the bootrom would otherwise come up as a
    USB drive). A tap now counts on release. Tap/hold logic is a pure,
    host-tested module (lib/input/button.c).
    - The USB host no longer refuses clocks that aren't a multiple of 12
    MHz: Pico-PIO-USB uses fractional dividers anyway, and full speed
    never had whole ones. Walked every mode with the USB ke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
2026-11-03 feature: automation HID for debug builds, replacing the keyboard CDC port
    The "VeeTee keyboard" CDC port stood in for a keyboard until the board
    had one; it had also stopped passing keys. Now:
    - Release builds present the line port alone.
    - Debug builds (new env:pizero-debug, or any debug env) add a vendor
    HID, "VeeTee automation": 64-byte reports, byte 0 the type
    (include/automation_hid.h). OUT: boot keyboard reports (through
    hidkbd, with their own state), typed xterm bytes (through keys.c),
    and a virtual BOOTSEL OR'd with the real one. IN: the debug text,
    which no longer goes down the terminal's line.
    - OUT reports arrive in TinyUSB's interrupt and queue in a ring for the
    main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
2026-11-03 docs: HAT interface for an RS-232 line and a PS/2 keyboard
    docs/hat.md pins out a HAT for the 40-pin header: UART0 with flow
    control on GPIO 12-15, PS/2 DATA/CLK on GPIO 16/17 for pio0's spare
    state machine (pio0 is rebased to 16, so PIO signals live in 16-27),
    and optional DTR/DCD/DSR/RI on 22-25. Includes the full header map,
    DE-9 DTE and mini-DIN-6 pinouts, the transceiver and level-shifter
    choices, and the constraints behind the pin choice. Firmware for
    either doesn't exist yet; the header's BCM positions still need
    checking against Waveshare's schematic.
2026-11-03 docs: full 40-pin header map in hat.md
    The previous commit said hat.md had the whole header map; it only had
    the assigned pins. Add the two-column Pi-numbered table with each
    pin's VeeTee use, for laying out the HAT in KiCad.
2026-11-03 docs: HAT pinout checked against the schematic, serial moves to UART1
    Waveshare's RP2350-PiZero schematic (J5, "40Pin OUT") shows the header
    is not BCM-numbered everywhere: eight GPIOs are moved so the pins'
    functions match a Pi (GPIO 4/5 = UART1 TX/RX on pins 8/10, SPI1 on
    19/21/23, GPIO 14/15/9 on 7/29/32). The old map assumed BCM positions,
    which put three UART pins on the wrong header pins.
    With 4/5 on the Pi's serial pins, the line moves to UART1 on GPIO 4-7
    (TXD 8, RXD 10, CTS 31, RTS 26), all plain F2 and still below pio0's
    reach. PS/2 (16/17 on pins 36/11) and the modem lines were already on
    correct pins. Pins 2/4 are noted as raw USB-C VBUS.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
2026-11-03 docs: hat.md header GPIOs are the chip's own numbers
    The schematic's J5 nets are named after, and wired to, the RP2350B's
    GPIO pins (GPIO0 on chip pin 77, GPIO4 on pin 1), so the header map's
    remapped pins are real wiring, not a labelling quirk.
2026-11-03 hardware: HAT schematic, RS-232 (TPT3122E) and PS/2
    New KiCad 10 project in hardware/, built through kicad-mcp-pro:
    - J1: 2x20 socket on the RP2350-PiZero header, wired per docs/hat.md
    (UART1 TX/RX/RTS/CTS on GPIO 4/5/7/6, PS/2 DATA/CLK on GPIO 16/17).
    - U1: 3PEAK TPT3122E RS-232 transceiver at 3.3 V (VCC and VL), 100 nF
    charge-pump caps, ~SHUTDOWN pulled up, ~ONLINE strapped up with a DNP
    pull-down alternative until the datasheet confirms the polarity.
    - J2: DB9 male wired as DTE (TXD/RXD/RTS/CTS only, as asked).
    - J3: PS/2 mini-DIN-6 behind two 2N7002 shifters (10k to 3.3 V, 4.7k
    to the fused 5 V), F1 polyfuse from VBUS with 10 uF + 100 nF.
    The board's own parts (TPT3122E, DB9, m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
2026-11-03 hardware: lay the HAT schematic out by block
    The auto-placed sheet scattered related parts and stacked text. It's
    rebuilt with fixed positions: the Pi header on the left, the TPT3122E
    and its capacitors/straps across the top, the PS/2 shifters, fuse and
    connector along the bottom. Pins connect through local labels on
    7.62 mm stubs.
    Power symbols that collided on dense pin rows are replaced with real
    wiring: J1's GND pins join a bus on each side with one GND symbol,
    U1's VCC/VL share one +3V3 and its GND has its own, and the DB9 and
    mini-DIN shells are tied to one GND each. All power symbols are
    upright; text sizes are uniform.
    The keyboard's fused rail is renamed PS2_5V (KiCad has no +5V_P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
2026-11-03 hardware: net labels sit on their wires, aligned toward the pin
    Following the convention set on the DB9 and C4 labels: every local
    label is at the free end of its stub, with its text lying along the
    wire and reading toward the pin. That's bottom-left when the wire runs
    right or up from the label (rotation 0/90) and bottom-right when it
    runs left or down (180/270), and each stub is at least long enough to
    hold its text. 37 stubs were extended collinearly; nothing new lies on
    an extension (checked against every wire end, label, no-connect and
    power pin before writing). J3's value field moved off its pin names.
    Netlist unchanged (24/24 planned nets, 33 flagged no-connects); ERC
    unchanged (the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
2026-11-03 hardware: level shifters become 2N7002W (SOT-323)
    Q1/Q2 swap from the stock 2N7002 (SOT-23, C8545) to the R+O 2N7002W
    in SOT-323 (C7420322): much smaller and on JLCPCB's preferred extended
    list, Vgs(th) 1.6 V so a 3.3 V gate still drives it. The symbol,
    footprint and 3D model are in the local library (imported from
    EasyEDA as local:2N7002W_C7420322).
    Its G/S/D pins sit exactly where the stock symbol's did (gate -5.08,
    source/drain +2.54 at +/-5.08), and EasyEDA's data agrees on 1=G,
    2=S, 3=D, so the swap is in place: same stubs, labels and +3V3 gate
    symbols. Netlist unchanged (24/24 nets, 33 flagged no-connects). ERC
    gains 6 pin-type warnings (33 total) because the imported symbol's
    pins ar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
2026-11-03 hardware: lay out and route the Pi Zero-size HAT
    65 x 40 mm board on the Pi Zero hole pattern (58 x 23 mm, M2.5),
    outline and connector placement by hand in KiCad, the rest driven
    live over KiCad's IPC API (kicad-python):
    - J1 2x20 socket on the bottom side, pin 1 (+3V3) on the inner row,
    matching KiCad's uHAT template; H1-H4 mounting holes added to the
    schematic so they come in with Update PCB.
    - DB9 flange and mini-DIN front on the bottom edge (DB9 shell
    overhangs), TPT3122E above the DB9, PS/2 shifters above the
    mini-DIN.
    - U1's charge-pump/decoupling caps fan out to its left, R1-R3 straps
    above it; CP1- loops over the top to C1. EP has two GND vias.
    - +3V3 from header pins 1 a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
2026-11-04 feature: the header's UART as the line; SET-UP split into pages; getty
    The communication line can now be the 40-pin header's UART1 (TX GPIO 4
    = pin 8, RX GPIO 5 = pin 10, CTS/RTS GPIO 6/7 = pins 31/26) instead of
    the USB CDC port, picked in SET-UP > Communications with speed (300 to
    115200), data bits, parity, stop bits and RTS/CTS flow control.
    - lib/hal/serial.c: interrupt-driven RX (8 KiB) and TX rings so a busy
    main loop doesn't overrun the 32-byte FIFO; RTS driven by hand from
    the ring's fill (the PL011's own RTS only follows its FIFO), CTS by
    the PL011; framing/parity/overrun counts.
    - app.c: line_read/line_write/line_apply choose the port; the idle
    CDC port is drained while o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
2026-11-04 hardware: the HAT's routing, plus devlog 024 reformatted
    Morgan's own work: the PCB and schematic as they stand after the latest
    routing pass in KiCad, and a formatting pass over devlog 024.
2026-11-04 render: feed host bytes only in the blanking gap
    Tearing: the main loop wrote the grid while the render IRQ was halfway
    down the frame, so a frame showed the top of one moment and the bottom of
    the next (brew upgrade's progress bars made it obvious).
    video.c now flags the gap itself: produce_lines clears in_gap when it
    renders line LEAD_LINES (ring 8 + TMDS buffers 4 = 12, the line the
    measured long pause falls before) and sets it again after the frame's
    last lead line. video_in_gap() exposes it; the check is two compares per
    line in produce_lines, so the renderer itself is untouched (the earlier
    wrapper in render.c cost ~130-140 cycles a line and was dropped).
    app.c's feed_line() reads 64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
2026-11-04 feature: a boot splash to help the capture card lock
    A fresh boot's nearly-black screen was slow to lock on the ShadowCast,
    while SET-UP's busy screen locked every time. The first 3 s after power
    on now show a small test card (192x108, doubled at 720p) centred on a
    navy screen.
    - tools/splash.py draws the default card into assets/splash.png and
    bakes any 192x108 PNG into lib/render/splash_image.c (4bpp, 16
    colours, 10 KB).
    - lib/render/splash.c paints it as a scanline function of its own;
    video_set_scanline() swaps it in and out with interrupts masked, so
    render_scanline's hot path is unchanged.
    - The pixels are copied into SET-UP's idle screen buffer for the
    duration (no XIP read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
2026-11-04 feature: 256x256 RGB565 splash, read straight from flash
    The splash only has to get a few frames out to the capture card, and
    the image is in flash already, so stop copying it: the painter reads
    128 KB of RGB565 straight from XIP, no palette, no RAM borrowed from
    SET-UP. Every image line is a cache miss, but 512 bytes a line is a few
    microseconds against a 25-32 us budget, for 3 s. Doubled to 512x512 at
    720p.
    The card gains a grey ramp and a hue sweep under the bars, and the
    screen's fill colour is now the image's top-right pixel, so a border and
    the fill can differ.
